Ismail2032004/embedded-driver-behavior-monitoring/hardware/renders/3d_layout_back.png

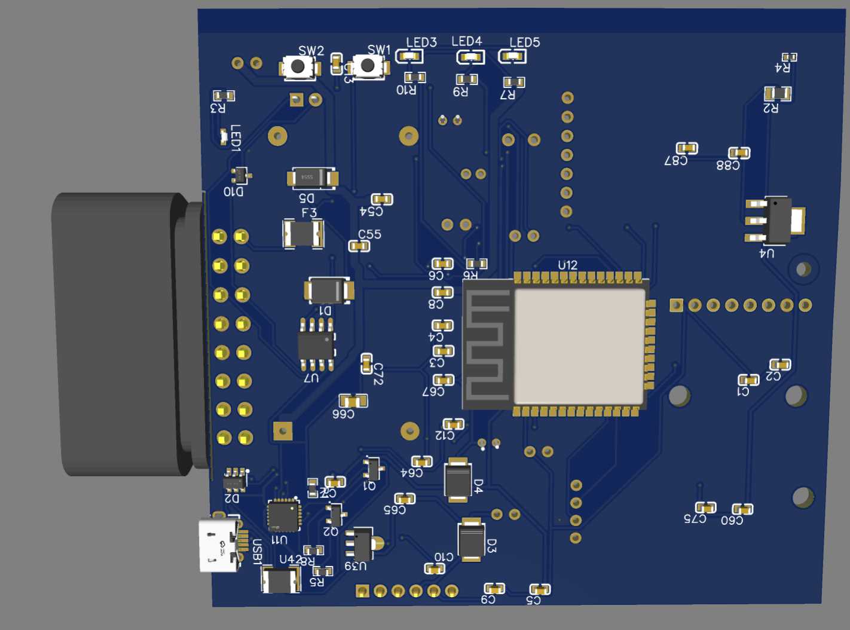
hardware/renders/3d_layout_back.png
