Ismail2032004/embedded-driver-behavior-monitoring/hardware/bom/bill_of_materials.csv

ID | Name | Designator | Footprint | Quantity | Manufacturer Part | Manufacturer | Supplier | Supplier Part | Price
1 | MHS190UBCT | LED1 | LED-SMD_L1.6-W0.6-R-RD_BLUE | 1 | MHS190UBCT | MEIHUA(美华) | LCSC | C409796 | 0.07
2 | XL-TD1608SURC | LED3,LED4,LED5 | LED0603-R-RD_RED | 3 | XL-TD1608SURC | XINGLIGHT(成兴光) | LCSC | C965849 | 0.036
3 | HX 3X4X2-2P-1.6N TACTILE SWITCH | SW1,SW2 | KEY-SMD_L4.0-W3.0-LS4.9-1 | 2 | HX 3x4x2-2P-1.6N TACTILE SWITCH | hanxia(韩下) | LCSC | C49234124 | 0.019
4 | 1uF | C12 | C0603 | 1 | 06033C105KAT2A | Kyocera AVX | LCSC | C597116 | 0.021
5 | 10kΩ | R1,R5,R8,R6 | R0603 | 4 | RE0603FRE0710KL | YAGEO(国巨) | LCSC | C723398 | 0.005
6 | 100nF | C6,C8,C72 | C0603 | 3 | CGA0603X7R104K250JT | HRE(芯声) | LCSC | C6119861 | 0.003
7 | 100nF | C67,C1,C3,C5,C9,C10,C13,C60,C64,C65 | C0603 | 10 | TCC0603X7R104K160CT | CCTC(三环) | LCSC | C20539422 | 0.003
8 | SS54BF | D3,D4 | SMBF_L4.3-W3.6-LS5.3-RD | 2 | SS54BF | SHIKUES(时科) | LCSC | C122867 | 0.078
9 | TPPESD1CAN-U | D10 | SOT-323-3_L2.0-W1.3-P1.30-LS2.1-BR | 1 | TPPESD1CAN-U | TECH PUBLIC(台舟) | LCSC | C558447 | 0.058
10 | S8050-SOT-23 | Q1,Q2 | SOT-23-3_L2.9-W1.3-P1.90-LS2.5-BR | 2 | S8050-SOT-23 | DDF(鼎德丰) | LCSC | C50229533 | 0.008
11 | ESP32-WROOM-32E(16MB) | U12 | WIFI-SMD_ESP32-WROOM-32E | 1 | ESP32-WROOM-32E-N16 | ESPRESSIF(乐鑫) | LCSC | C701343 | 4.764
12 | AMS1117-3.3(SOT-89)_C47283698 | U39 | SOT-89-3_L4.5-W2.4-P1.50-LS4.0-BR | 1 | AMS1117-3.3(SOT-89) | TWGMC(迪嘉) | LCSC | C47283698 | 0.027
13 | CP2104-F03-GM | U11 | QFN-24_L4.0-W4.0-P0.50-BL-EP2.7 | 1 | CP2104-F03-GMR | SKYWORKS/SILICON LABS(芯科) | LCSC | C47742 | 2.202
14 | HX USB-MICRO XNJ JB | USB1 | MICRO-USB-SMD_HX-USB-MICRO-XNJ-JB | 1 | HX USB-MICRO XNJ JB | hanxia(韩下) | LCSC | C18357556 | 0.052
15 | 10uF | C2,C4,C7,C75 | C0603 | 4 | TCC0603X5R106K100CT | CCTC(三环) | LCSC | C380314 | 0.011
16 | 100nF | C54,C87 | C0603 | 2 | TCC0603X7R104M500CT | CCTC(三环) | LCSC | C282670 | 0.003
17 | 1uF | C55,C88 | C0603 | 2 | TCC0603X7R105K500CT | CCTC(三环) | LCSC | C5360793 | 0.01
18 | 10uF | C66 | C0805 | 1 | 0805X7R106K250NT | AIDE(爱迪电容) | LCSC | C48579607 | 0.041
19 | USBLC6-2SC6_C2827654 | D2 | SOT-23-6_L2.9-W1.6-P0.95-LS2.8-BL | 1 | USBLC6-2SC6 | TECH PUBLIC(台舟) | LCSC | C2827654 | 0.04
20 | SS54A | D5 | SMA_L4.2-W2.6-LS5.1-RD | 1 | SS54A | FUXINSEMI(富芯森美) | LCSC | C842792 | 0.043
21 | 330Ω | R3 | R0603 | 1 | WR06X331JTL | Walsin(华新科) | LCSC | C384242 | 0.001
22 | 3.3kΩ | R7 | R0603 | 1 | TD03G3301BT | FH(风华) | LCSC | C666978 | 0.028
23 | 1kΩ | R9,R10 | R0603 | 2 | RMC 0603 1K J N | Tyohm(幸亚电阻) | LCSC | C5362357 | 0.003
24 | SMD1812-110C-33V | F3 | F1812 | 1 | SMD1812-110C-33V | BNstar(比诺星) | LCSC | C2760290 | 0.061
25 | MF-MSMF050-2 | U42 | F1812 | 1 | MF-MSMF050-2 | BOURNS | LCSC | C17313 | 0.067
26 | SN65HVD232DR | U7 | SOIC-8_L5.0-W4.0-P1.27-LS6.0-BL | 1 | SN65HVD232DR | TI(德州仪器) | LCSC | C30530 | 0.654
27 | SMBJ24A_C908801 | D1 | SMB_L4.4-W3.6-LS5.3-RD | 1 | SMBJ24A | GOODWORK(固得沃克) | LCSC | C908801 | 0.042
28 | 120Ω | R2 | R0805 | 1 | 0805W8F1200T5E | UNI-ROYAL(厚声) | LCSC | C17437 | 0.002
29 | 280Ω | R4 | R0402 | 1 | 0402WGF2800TCE | UNI-ROYAL(厚声) | LCSC | C423200 | 0.001
30 | AMS1117-ADJ_C22466224 | U4 | SOT-223-3_L6.7-W3.7-P2.30-LS7.0-BR_2 | 1 | AMS1117-ADJ | TDSEMIC(拓电半导体) | LCSC | C22466224 | 0.033
31 | 10uF | C19 | CAP-TH_BD5.0-P2.00-D0.8-FD-10UF50VC110GL | 1 | 10UF50VC110GL | Econd(米朗电子) | LCSC | C46867109 | 0.015
32 | 22uF | C20 | CAP-TH_BD5.0-P2.00-D0.5-FD | 1 | 50YXA22MEFC5X11 | Rubycon(红宝石) | LCSC | C4153647 | 0.054
33 | SIM7670E_BreakOut | U3 | SIM7670E_BK_FOOTPRINT | 1
34 | 100uF | C11,C14,C15,C16,C17 | CAP-TH_BD6.3-P2.50-D0.5-FD-100UF25V6.3X11KM | 5 | 100uF25V6.3x11KM | Econd(米朗电子) | LCSC | C49304911 | 0.01
35 | 470uF | C18 | CAP-TH_BD8.0-P3.50-D0.5-FD_470UF25VF140KM | 1 | 470UF25VF140KM | Econd(米朗电子) | LCSC | C46867098 | 0.044
36 | 47uF | U1 | CAP-TH_BD5.0-P2.00-D0.5-FD-1 | 1 | JBLE2470M025A080RLM 47UF 25V | DMBJ(振宝佳) | LCSC | C19270656 | 0.131
37 | 120 OHM | 120_OHM_RES | HDR-TH_2P-P2.54-V-F | 1 | PM2.54-1X2PM-H85 | JXTCONN(聚兴泰) | LCSC | C42431841 | 0.066
38 | UBLOX NEO-6M (BLUE) | GPS1 | GY-NEO6MV2 | 1 | GY-NEO6MV2 |  |  | GY-NEO6MV2
39 | Header-Male-2.54_1x6 | H3 | HDR-TH_6P-P2.54-V-M-1 | 1 | 2.54-1x6P直针 | BOOMELE(博穆精密) | LCSC | C37208 | 0.037
40 | LM2596 | U2 | LM2596:YAAJ_DCDC_STEPDOWN_LM2596 | 1
41 | MPU6050_DL | U8 | MPU6050 | 1 |  |  | Digi-Key
42 | OBD2-MALE-16PIN | U27 | CONN-TH_OBD2 | 1 | OBD2-male-16pin | null | LCSC | C9900147921
