Ismail2032004/embedded-driver-behavior-monitoring/hardware/schematics/esp32_driver_monitor_schematic.pdf

VIN_PROT | EXTERNAL HEADERS

# 12V with Protection

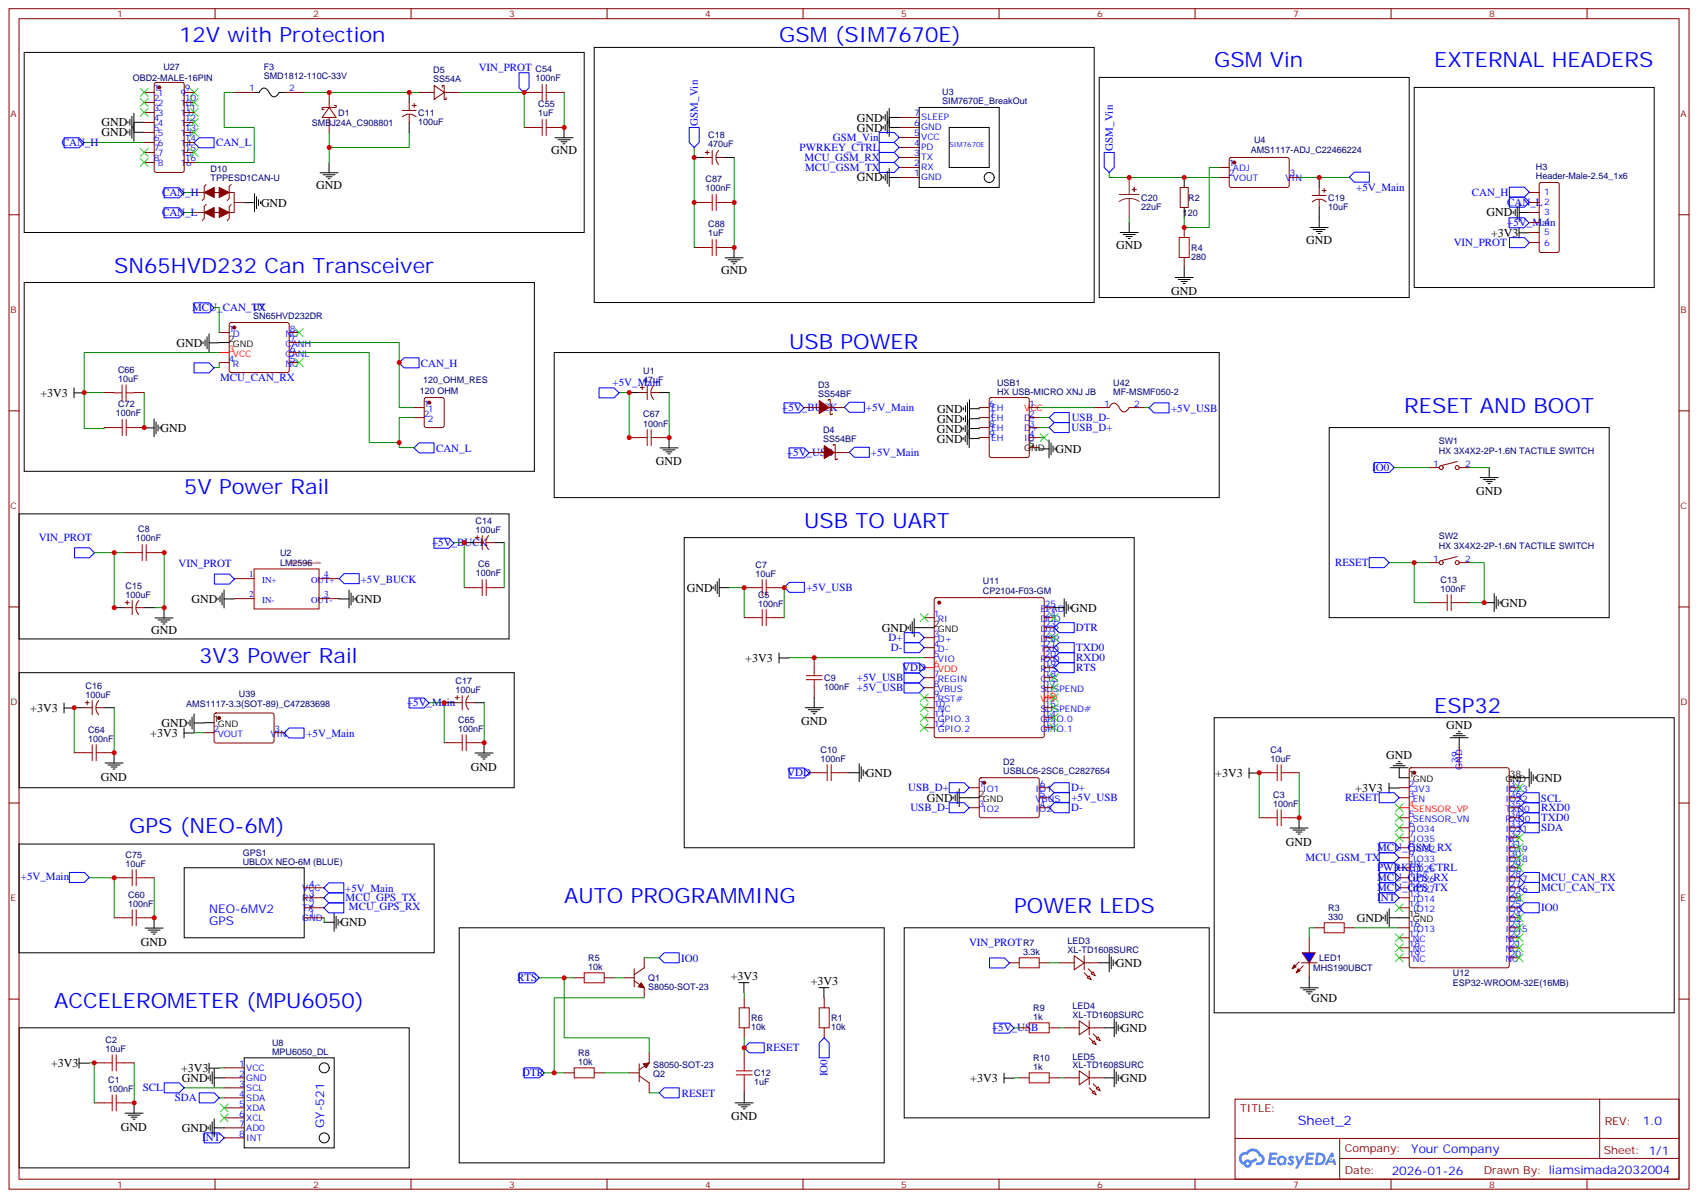
[picture p5: page 1]
