Ismail2032004/embedded-driver-behavior-monitoring/(commit log)

2026-04-05 Add ESP32 firmware with embedded ML inference pipeline
2026-04-05 Add hardware design files (schematic, gerbers, BOM, PCB project)
    [bill_of_materials.csv, pick_and_place.csv]
2026-04-05 Add Flutter mobile app prototype
2026-04-05 Add driver dashboard
